oktane/Ford_High_Idle_Controller/images/schematic.jpg

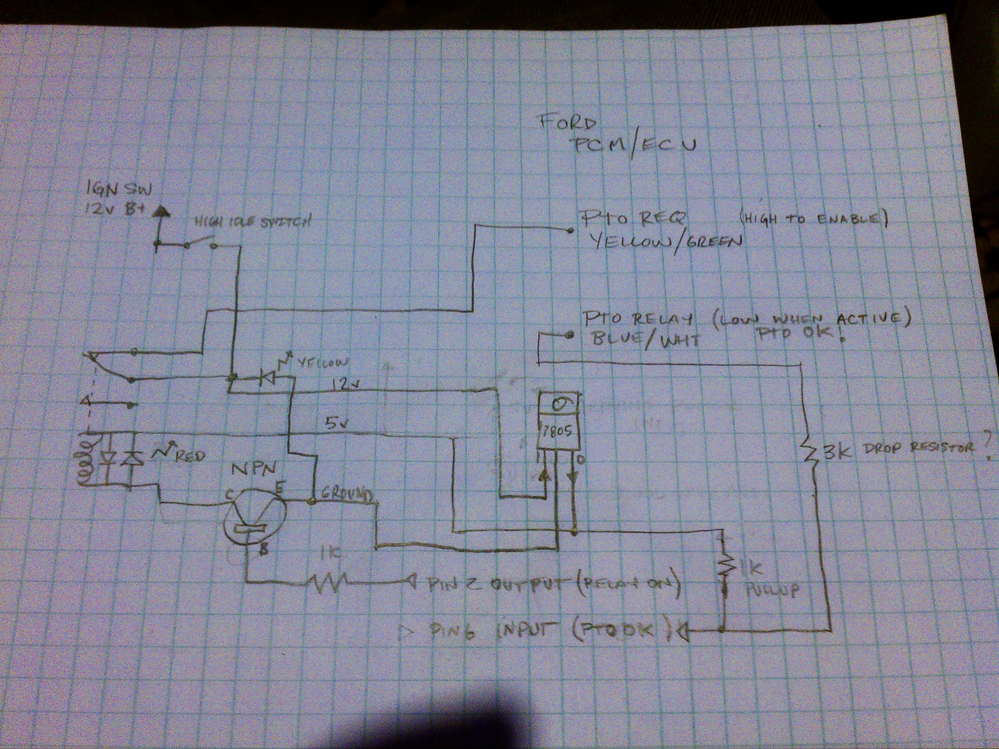
images/schematic.jpg
