oktane/Ford_High_Idle_Controller/images/IMG_20111227_154033.jpg

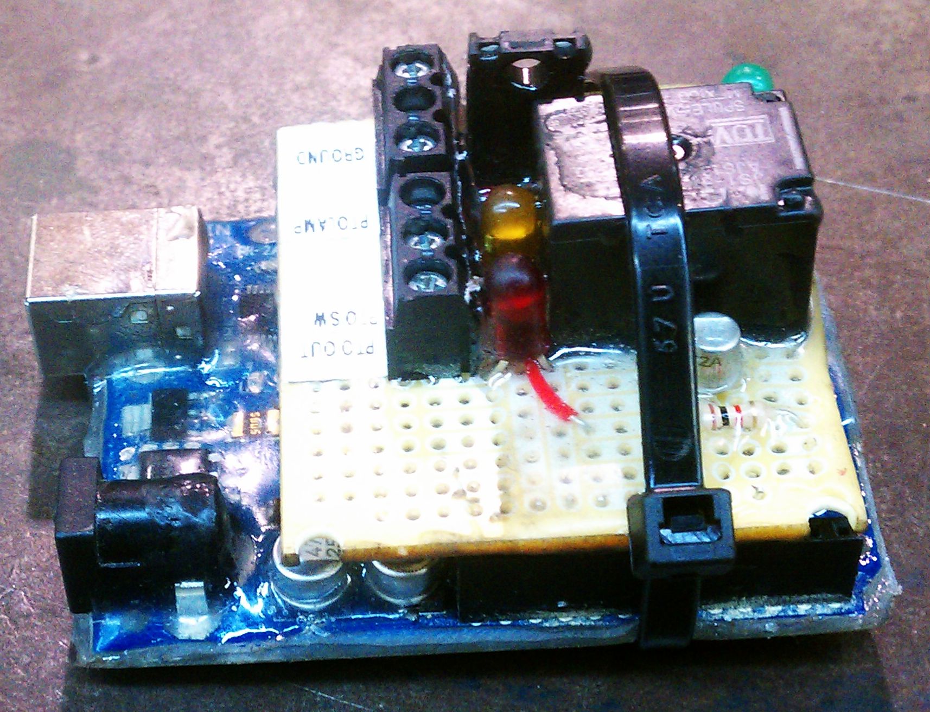
images/IMG_20111227_154033.jpg
