oktane/Ford_High_Idle_Controller/images/IMG_20111228_105944.jpg

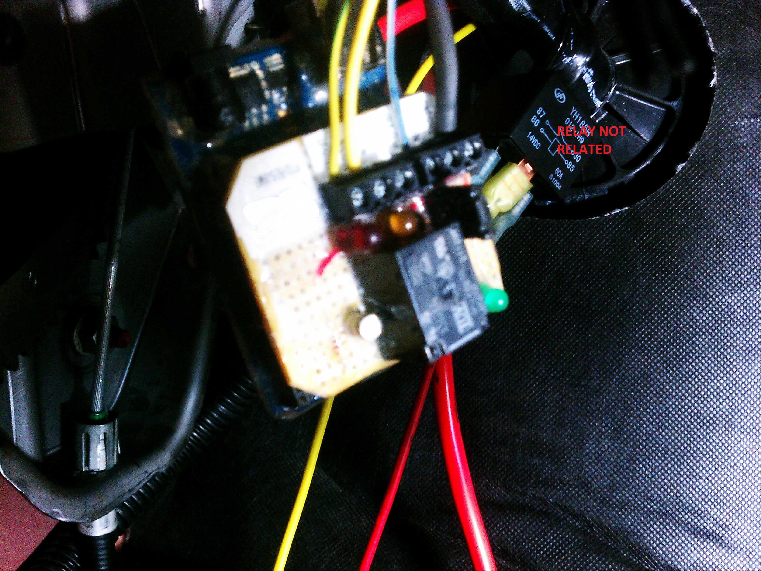
images/IMG_20111228_105944.jpg
